vs0100/LDO_design/Graphs/45_ext_OL_l.png

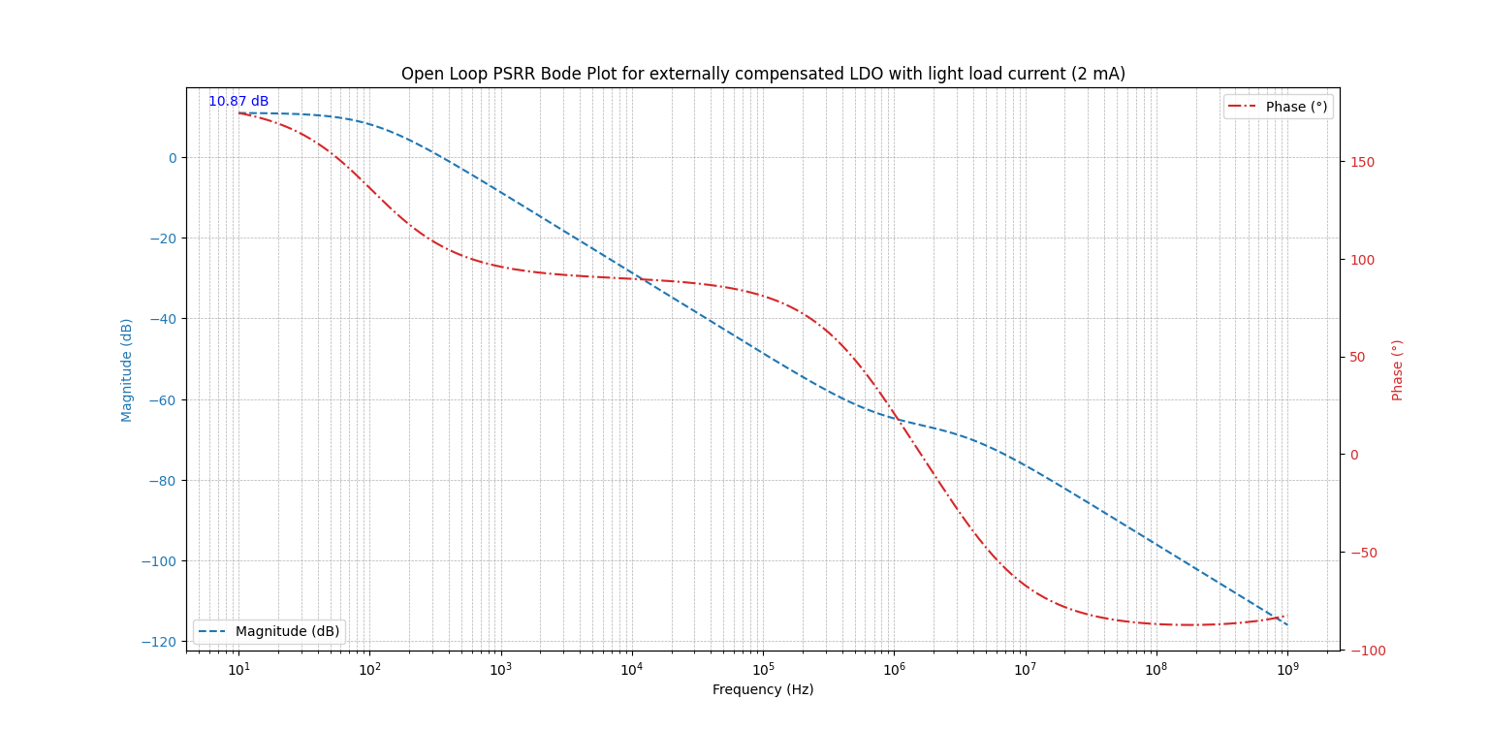
Graphs/45_ext_OL_l.png
