vs0100/LDO_design/Graphs/130nm_ext_CL.png

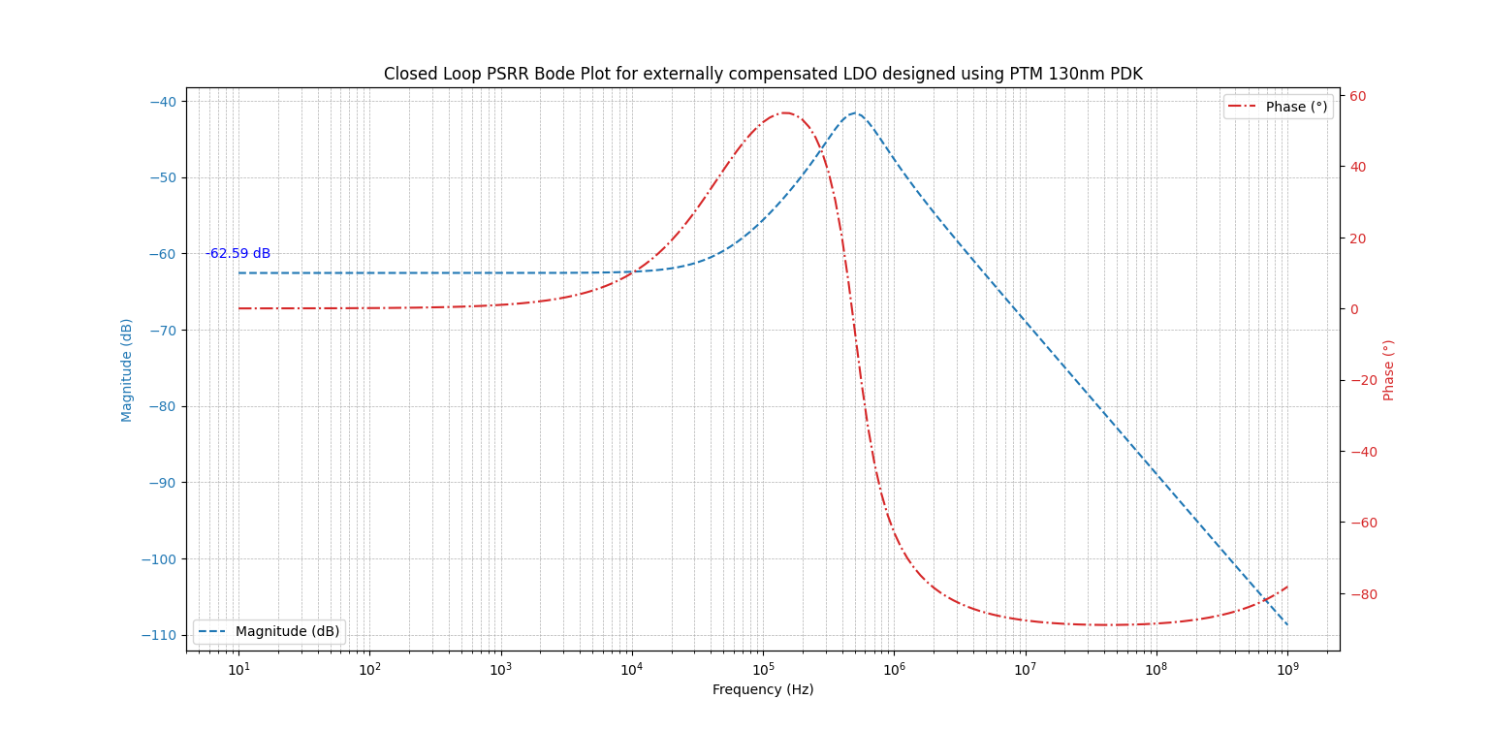
Graphs/130nm_ext_CL.png
