vs0100/LDO_design/Graphs/130nm_ext_OL.png

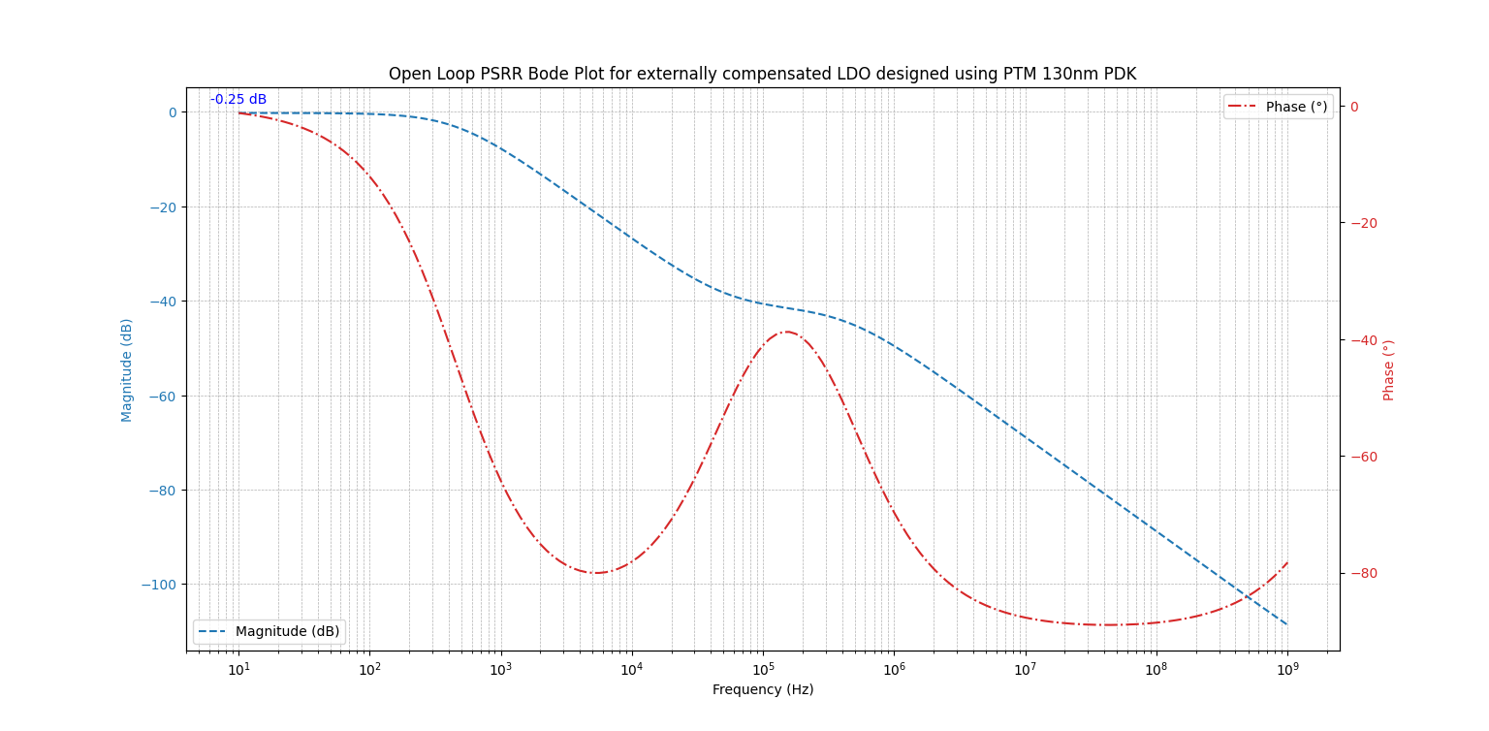
Graphs/130nm_ext_OL.png
