vs0100/LDO_design/ptm045/nmos_ltspice/nmos ayunit_csv.png

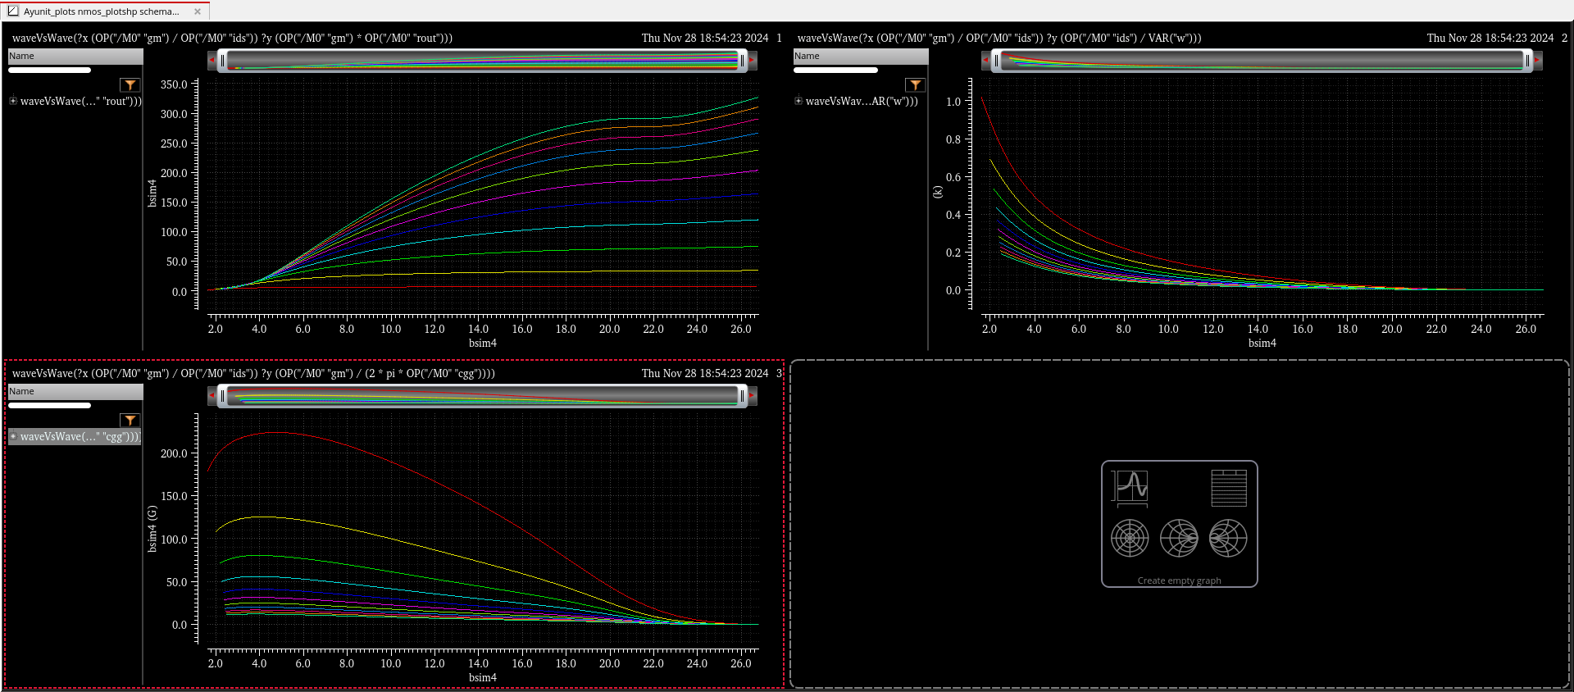
ptm045/nmos_ltspice/nmos ayunit_csv.png
