vs0100/LDO_design/ptm045/pmos_ltspice/ayunit pmos.png

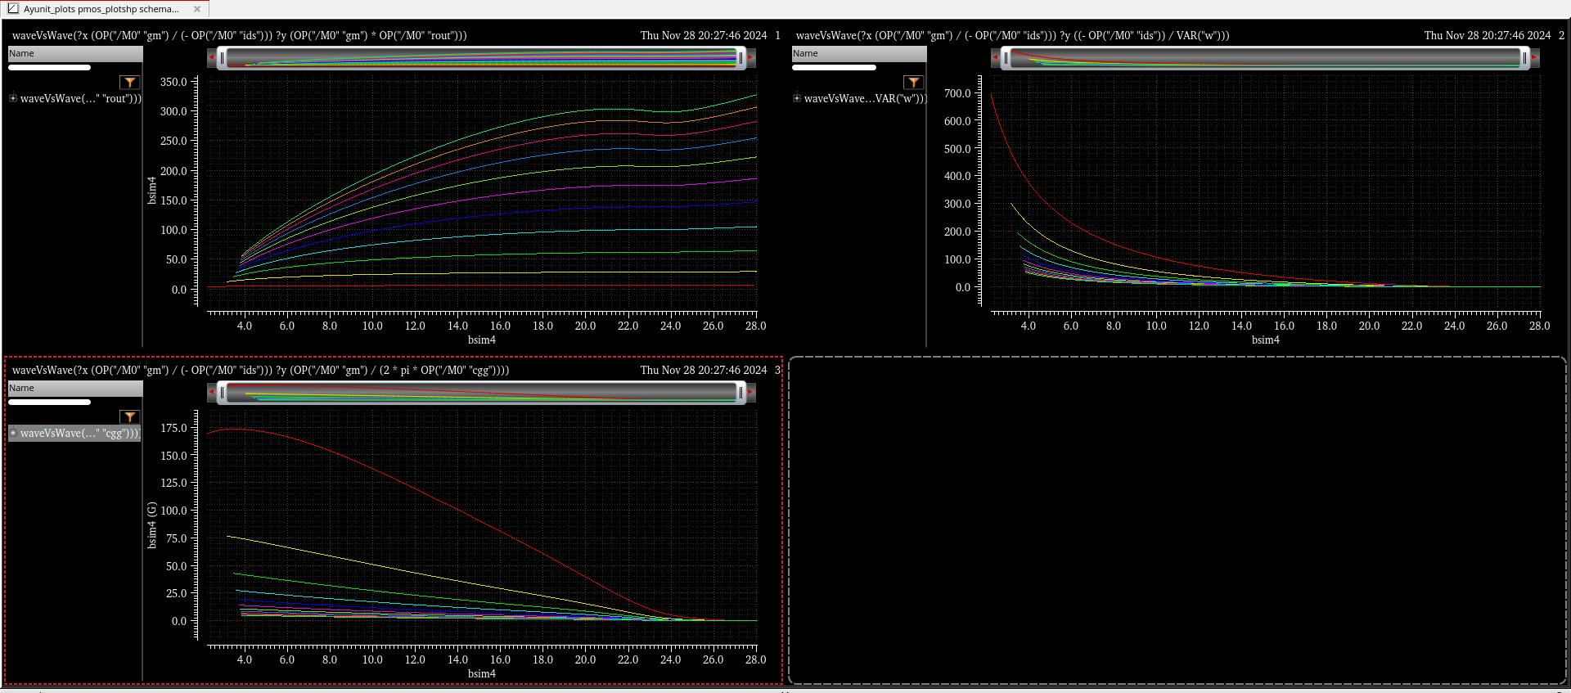
ptm045/pmos_ltspice/ayunit pmos.png
