vs0100/LDO_design/Screenshots/nmos_ft.png

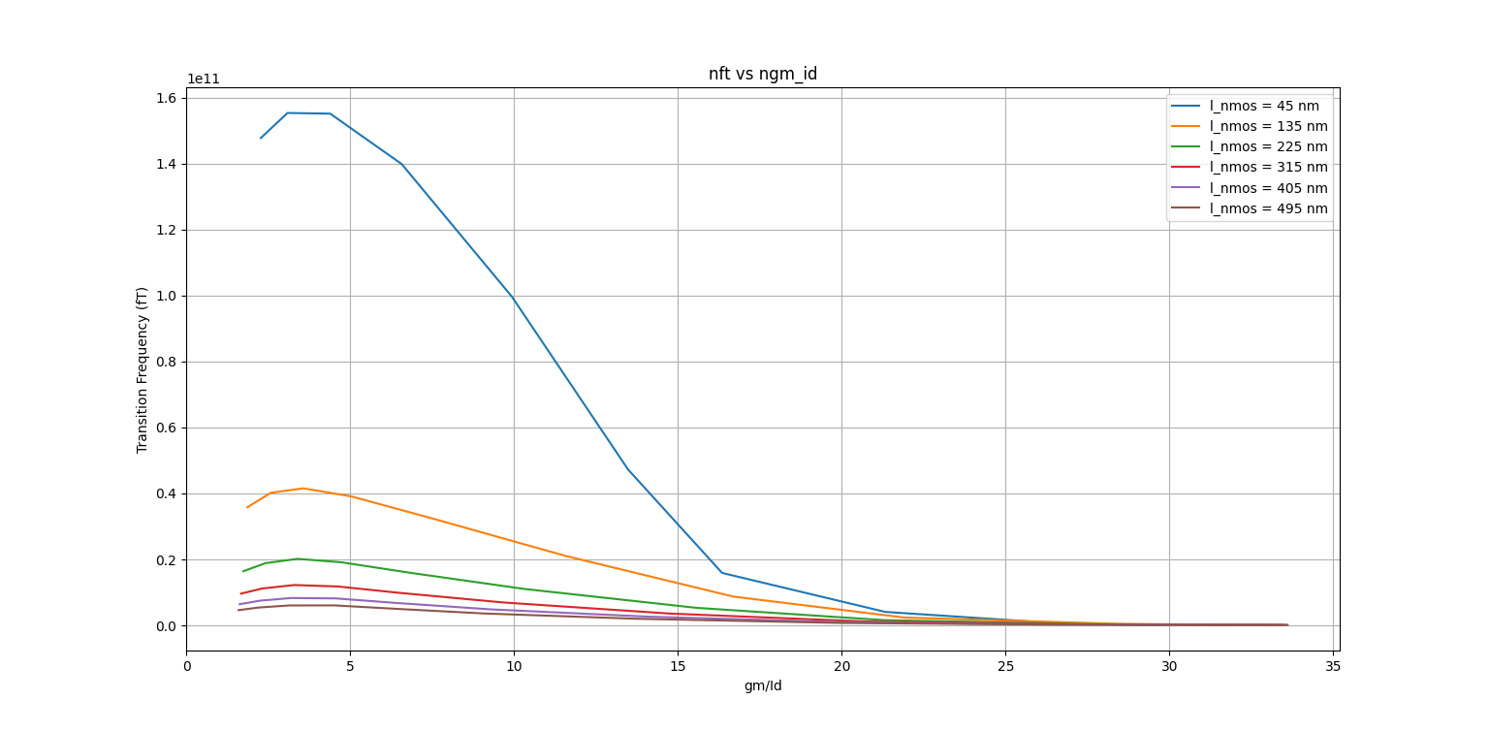
Screenshots/nmos_ft.png
