vs0100/LDO_design/Screenshots/nmos_gmro.png

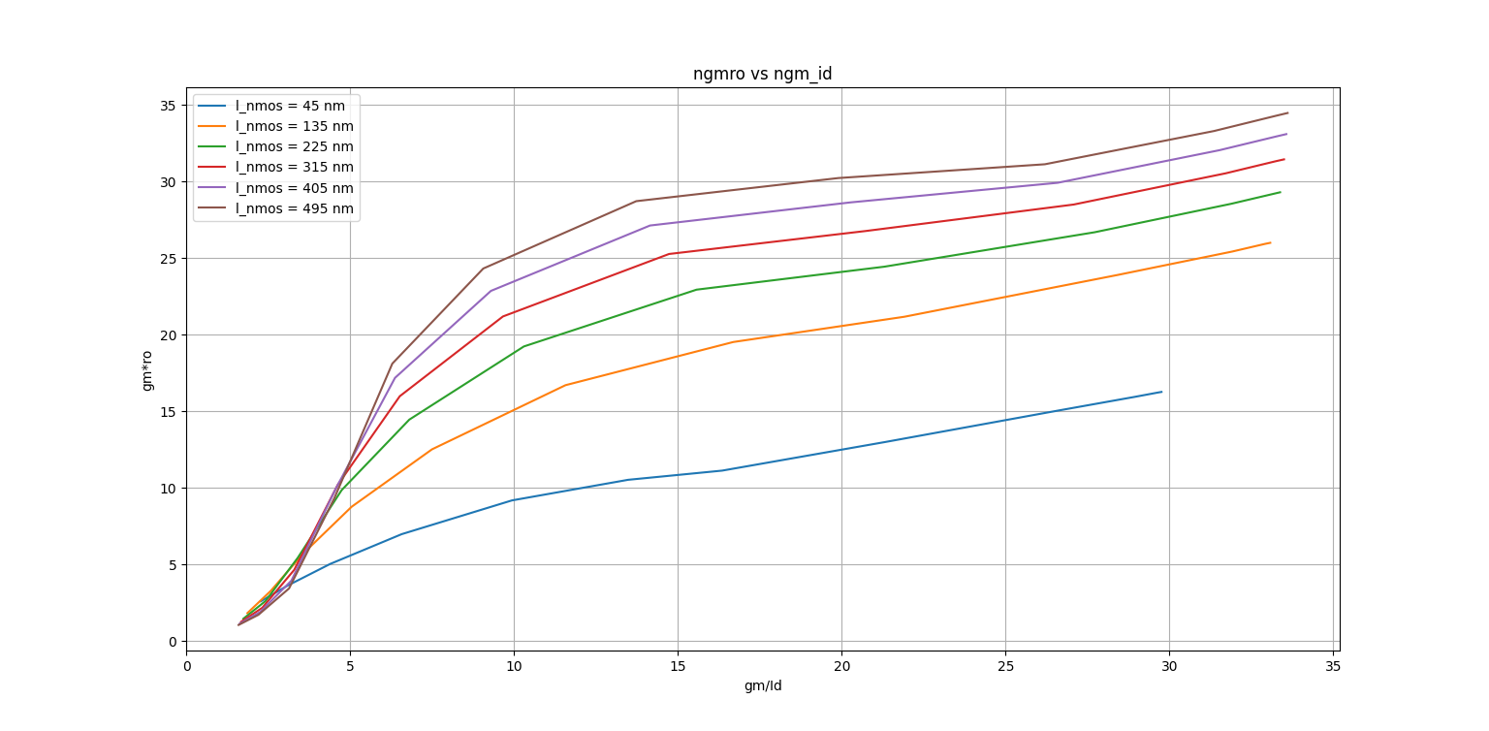
Screenshots/nmos_gmro.png
