vs0100/LDO_design/Screenshots/nmos_idw.png

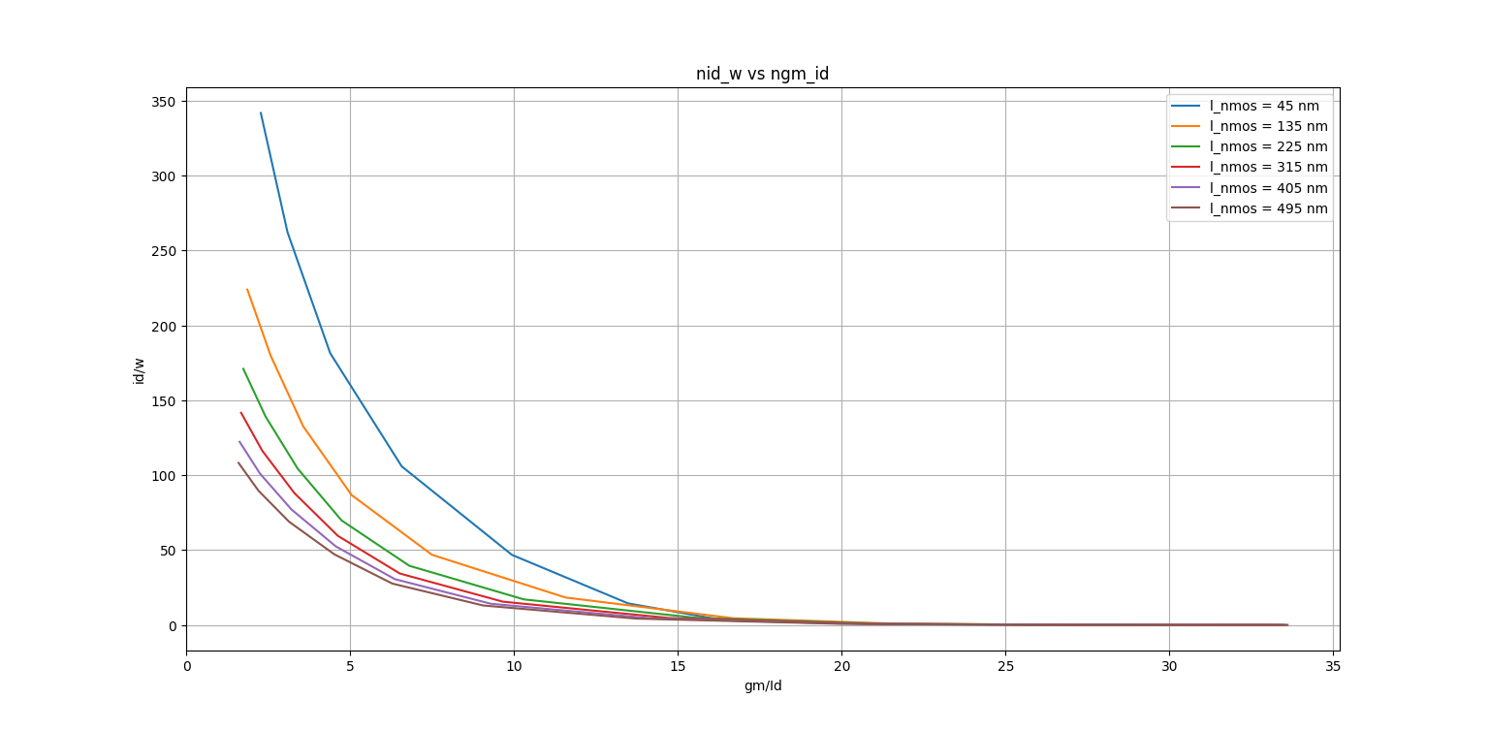
Screenshots/nmos_idw.png
