vs0100/LDO_design/Screenshots/pmos_gmro.png

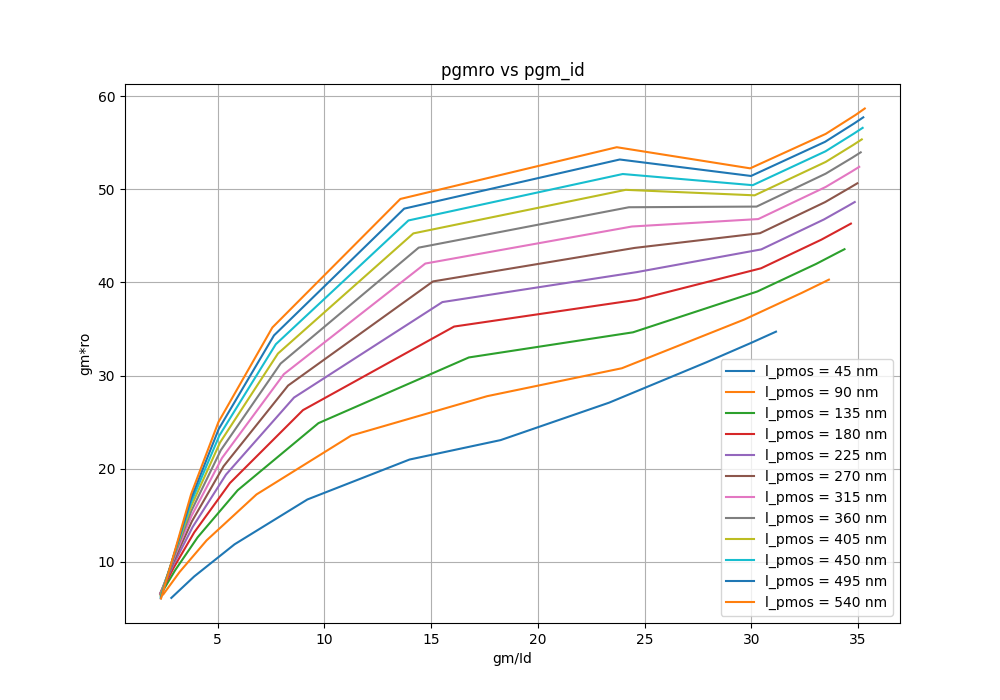
Screenshots/pmos_gmro.png
