vs0100/LDO_design/Screenshots/pmos_ltspice_07_ft.png

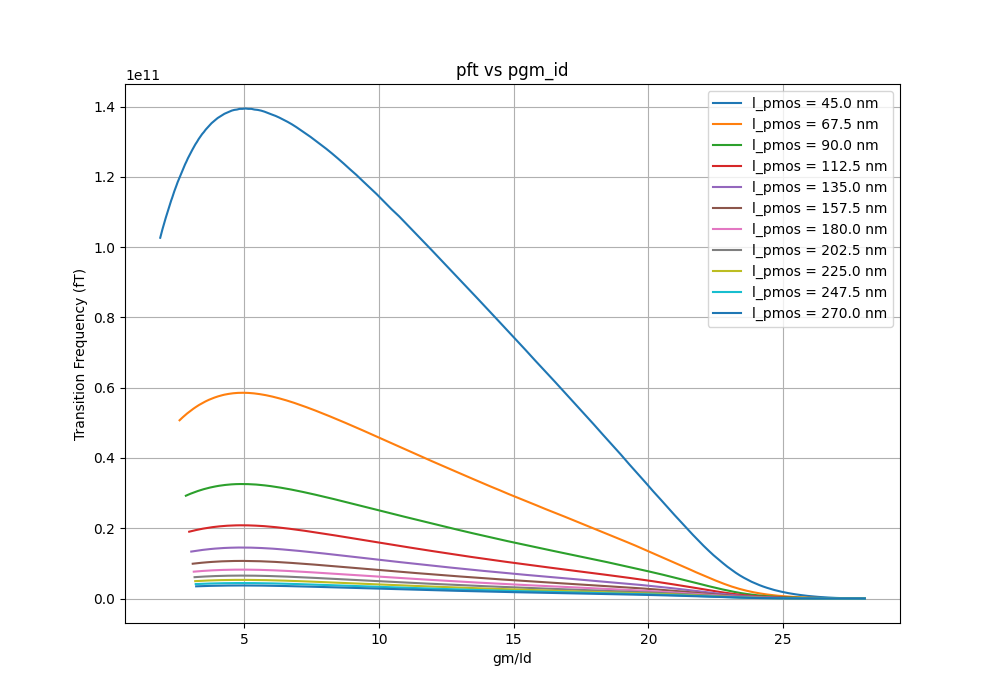
Screenshots/pmos_ltspice_07_ft.png
