vs0100/LDO_design/Circuits/Final/LDO_180/502_PSRR_Demo.asc

C2: cap; 1µ
C3: cap; 1
I1: current; {ibias}
Iload: current; 10m
M1: nmos; nmos292p; L=l1 W=Wdiff
M2: nmos; nmos292p; L=l1 W=Wdiff
M3: nmos; nmos292p; L=0.72u W=10u
M4: pmos; pmos292p; L=lload W=Wload
M5: pmos; pmos292p; L=lload W=Wload
M7: nmos; nmos292p; L=0.72u W=10u
M8: nmos; nmos292p; L=0.72u W=10u
MPass: pmos; pmos292p; L=0.18u W=Wpass
R1: res; 1G
V1: voltage; 1.4; AC 0
V2: voltage; 1
V3: voltage; 0; AC 1
Named nets: 0, Bias, OUT, Vdd, Vref, OTAout
.include models_292p.txt
.ac dec 20 10 1G
;.op
.param ibias=50u
.param l1=0.72u
.param lload=0.18u
;tran 400u
Please set the parameters in all the .param statements below
.param Wload=2.7u
.param Wdiff=4.31u
.param Wpass=1132u
.param Cload=1u
You can also use the middlebrook mthod to find the stability.
Please set the parameters in all the .param statements below
The method here of breaking the loop and evaluating loop gain works well for a high impedance node, but not always.
Middlebrook method is the best way to go. You can find an example in the educational folder of examples in LTspice folder.
AC analysis
