vs0100/LDO_design/Circuits/Final/LDO_180/LDO_Telescopic_CL.asc

C1: cap; {CLoad}
I1: current; {IBias}
I2: current; {ILoad}
M1: nmos4; l={nL_Diff} w={nW_Diff}
M2: nmos4; l={nL_Diff} w={nW_Diff}
M3: nmos4; l={nL_Diff} w={nW_Diff}
M4: nmos4; l={nL_Diff} w={nW_Diff}
M5: nmos4; l={L_Mirr} w={W_Mirr}
M6: pmos4; l={pL_Diff} w={pW_Diff}
M7: pmos4; l={pL_Diff} w={pW_Diff}
M8: pmos4; l={pL_Diff} w={pW_Diff}
M9: pmos4; l={pL_Diff} w={pW_Diff}
M10: pmos4; l=L_pass w=W_pass
M11: nmos4; l={L_Mirr} w={W_Mirr}
M12: nmos4; l={L_Mirr} w={W_Mirr}
V1: voltage; 1.8; AC 1
V2: voltage; 1.2
V3: voltage; 1
V4: voltage; 0.8
Named nets: 0, VRef, Vdd, Bias, VBias, VBias_p
.param ILoad 10m
.param CLoad 1u
.param IBias 50u
.param pL_Diff 180n
.param pW_Diff 2.8u
.param nL_Diff 180n
.param nW_Diff 1u
.param L_pass 180n
.param W_pass 1.08m
.include "models_292p_new.txt"
.param L_Mirr 1260n
.param W_Mirr 13u
.ac dec 10 10 1G
.op
.tran 1m
