vs0100/LDO_design/Circuits/Final/LDO_45/Draft1.asc

C1: cap; {CLoad}
I1: current
I2: current; {ILoad}
M1: nmos4; l={nL_Diff} w={nW_Diff}
M2: nmos4; l={nL_Diff} w={nW_Diff}
M3: nmos4; l={nL_Diff} w={nW_Diff}
M4: nmos4; l={nL_Diff} w={nW_Diff}
M5: nmos4
M6: pmos4; l={pL_Diff} w={pW_Diff}
M7: pmos4; l={pL_Diff} w={pW_Diff}
M8: pmos4; l={pL_Diff} w={pW_Diff}
M9: pmos4; l={pL_Diff} w={pW_Diff}
M10: pmos4; l=L_pass w=W_pass
M11: nmos4
M12: nmos4
V1: voltage
V2: voltage
Named nets: 0
.param ILoad 10m
.param CLoad 1u
.param IBias 50u
.param pL_Diff 135n
.param pW_Diff 1.2u
.param nL_Diff 90n
.param nW_Diff 280n
.param L_pass 90n
.param W_pass 270u
