vs0100/LDO_design/Circuits/Final/LDO_45/LDO_45nm_90_CL_Cat2.asc

CLoad: cap; {CLoad}
I1: current; {IBias}
ILoad: current; {ILoad}
M1: pmos4; l=pL_Diff w=pW_Diff
M2: pmos4; l=pL_Diff w=pW_Diff
M3: nmos4; l=nL_Diff w=nW_Diff
M4: nmos4; l=nL_Diff w=nW_Diff
M5: nmos4; l={L_Mirr} w={W_Mirr}
M6: nmos4; l={L_Mirr} w={W_Mirr}
M8: nmos4; l={L_Mirr} w={W_Mirr}
MPass: pmos4; l=L_pass w=W_pass
V1: voltage; 1.4; AC 1
V2: voltage; 1
Named nets: 0, Vdd, VRef, Bias, OTA_Out, Out
.include "45nm_HP.sp"
.param IBias 40u
.param ILoad 10m
.param CLoad 10n
.op
.ac dec 20 10 1G
.param L_Mirr 270n
.param W_Mirr 17.4u
.param pL_Diff 135n
.param pW_Diff 5.4u
.param nL_Diff 90n
.param nW_Diff 2.9u
.param L_pass 90n
.param W_pass 2.7m
