vs0100/LDO_design/(commit log)

2024-11-28 Update repo
    [ft.csv, gmro.csv, idw.csv]
2024-12-05 Update changes
    [Miller_45nm.xlsx]
